scramble-robot/CoRE_AutoRobot_2024_general/(commit log)

2025-01-07 最新ハードに合わせてサンプルを修正
2025-01-07 最新ハードに合わせて内容を修正
2025-01-07 Revert "最新ハードに合わせて内容を修正"
    This reverts commit d4ebf4b16d820c66d9f84ed4a21eecb0191920d7.
2025-01-28 ダメージパネルに関する表記を修正
